ByCoCandy/buddy/Image/9bd2c3c765185578ac3aac7fdcc3a110.png

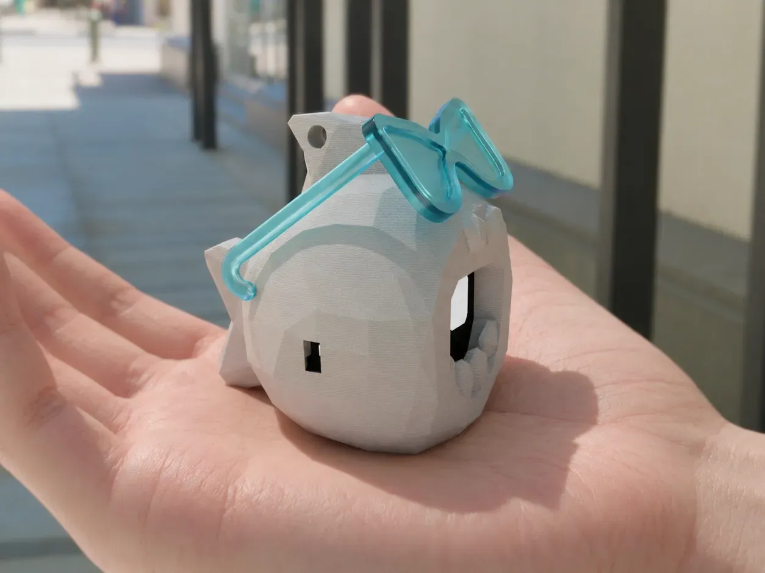
Image/9bd2c3c765185578ac3aac7fdcc3a110.png
