ByCoCandy/buddy/Model/textures/8d1633a87402a765b459fc35e493106d.png

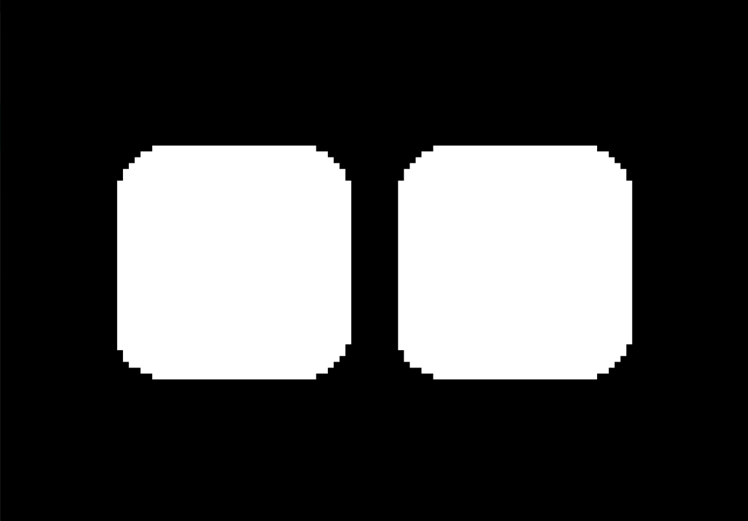
Model/textures/8d1633a87402a765b459fc35e493106d.png
