ByCoCandy/buddy/Image/材料清单.jpg

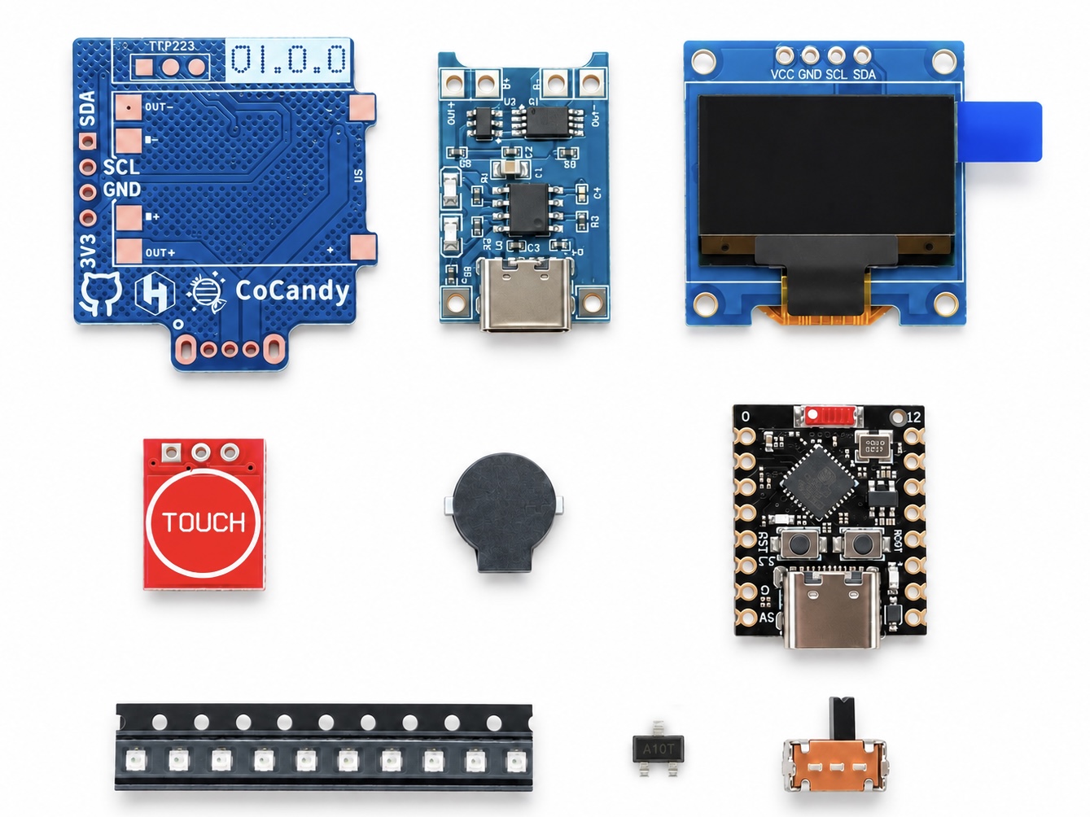
Image/材料清单.jpg
