ByCoCandy/buddy/Model/step/left.stp

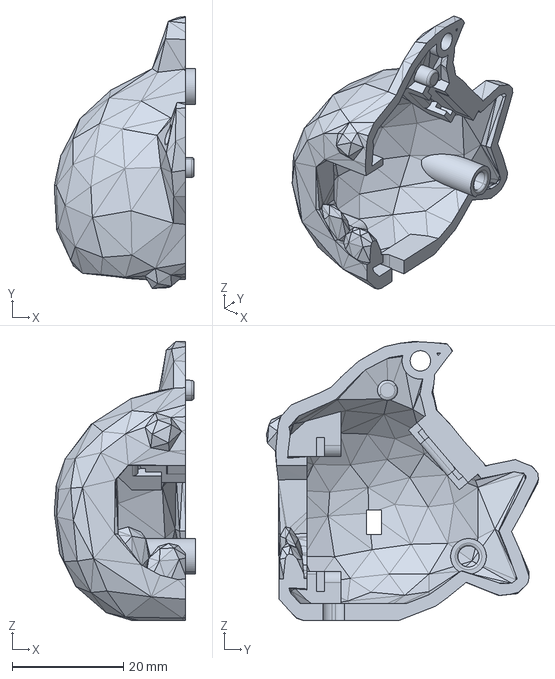
[picture p19: CAD file, 2026-11-13]
Model/step/left.stp
25.4 x 48.8 x 50.1 mm
