ByCoCandy/buddy/Model/step/right.stp

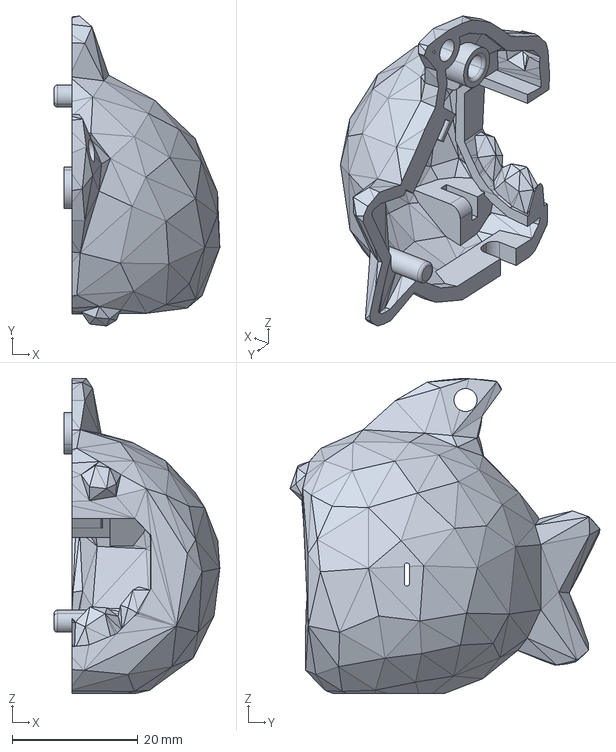
[picture p20: CAD file, 2026-11-13]
Model/step/right.stp
26.3 x 49.2 x 50.1 mm
