ByCoCandy/buddy/(list of files, cad)

Other CAD files:
Model/model-blender-res.blend
Model/model-rhino-res.3dm
